chirayujain/LithoLamp/Electronics/DriverBoard/DriverV2_BOM.xlsx

Item # | REFDES | Qty | Manufacturer | MPN/Link | Value/Description | Package
1 | R1 | 1 | YAGEO | RC0603FR-076K04L | 6k | R_0603
2 | R2 | 1 | YAGEO | RC0603FR-0714KL | 14k | R_0603
3 | R3, R4, R5 | 3 | YAGEO | RC0603FR-075K1L | 5.1k | R_0603
4 | R6, R7 | 2 | YAGEO | RC0603JR-0727RL | 27 | R_0603
5 | R8, R12, R14, R15, R16, R17, R18, R19, R20, R21, R24 | 11 | YAGEO | RC0603FR-0710KL | 10k | R_0603
6 | R9 | 1 | Stackpole Electronics | RMCF0603FT10R0 | 10 | R_0603
7 | R10 | 1 | YAGEO | RC0603FR-0749K9L | 49.9k | R_0603
8 | R11, R13 | 2 | YAGEO | RC0603FR-071KL | 1k | R_0603
9 | R26 | 1 |  |  | 0 | R_0603
10 | C1, C2, C3, C4, C5, C7, C8, C9, C11 | 9 | Murata | GRM155R71C104KA88J | 100n | C_0402
11 | C6, C16, C17 | 3 | YAGEO | CC0603KRX7R7BB105 | 1uF | C_0603
12 | C10, C12 | 2 | Taiyo Yuden | LMK105BJ105KV-F | 1u | C_0402
13 | C13, C14, C15 | 3 | Murata | GRT188R61E475KE13D | 4.7uF | C_0603
14 | C18, C19 | 2 | Murata | GRM188R61E106MA73D | 10uF | C_0603
15 | C20 | 1 | Murata | GCM188R71H104KA57J | 100n | C_0603
16 | C21, C22 | 2 | Walsin Technology | 0603N150F500CT | 15pF | C_0603
17 | D1, D2 | 2 | Onsemi | NSR0320MW2T1G | NSR0320MW2T1G | SOD-323
18 | Q1 | 1 | Alpha & Omega Semiconductor | AONR21307 | AONR21307 | 8-DFN-EP (3x3)
19 | Q2, Q3, Q4, Q5 | 4 | Onsemi | BSS138 | BSS138 | SOT23-3
20 | Q7 | 1 | Alpha & Omega Semiconductor | AO3422 | AO3422 | SOT23-3
21 | X1 | 1 | Abracon | ABM8-272-T3 | 12MHz Crystal | 4-SMD
22 | U1 | 1 | Raspberry Pi | SC0914(13) | RP2040 | QFN40P700X700X90-57N
23 | U2 | 1 |  |  | HUSB238 | DFN10_3X3MM
24 | U3 | 1 | Texas Instruments | TLV76750DRVR | TLV76701DRVR | 6-WSON (2x2)
25 | U4 | 1 | Diodes Inc. | AP2112K-3.3TRG1 | AP2112K-3.3TRG1 | SOT-25
26 | U5 | 1 | Winbond Electronics | W25Q128JVSIQ TR | W25Q128JVSIQ | SOIC127P790X216-8N
27 | U6 | 1 | STMicroelectronics | ULN2003D1013TR | ULN2003D | SO-16_STM-M
28 | SW1, SW2 | 2 | C&K | KMR211NG LFS | SPST_TACT-KMR2 | KMR2
29 | J1, J2 | 2 | GCT | USB4105-GF-A | USB4105-GF-A | GCT_USB4105-GF-A
30 | J3 | 1 | JST | B5B-XH-A | B5B-XH | JST_B5B-XH-A(LF)(SN)
31 | J4 | 1 |  |  | PINHD-1X02_1X02M | 1X02
32 | J5 | 1 |  |  | PINHD-1X05_1X05M | 1X05
33 | J6 | 1 |  |  | Solder Jumper | SOLDERJUMPER_ARROW_NOPASTE
