chirayujain/LithoLamp/CAD/STLs/baseTop.stl

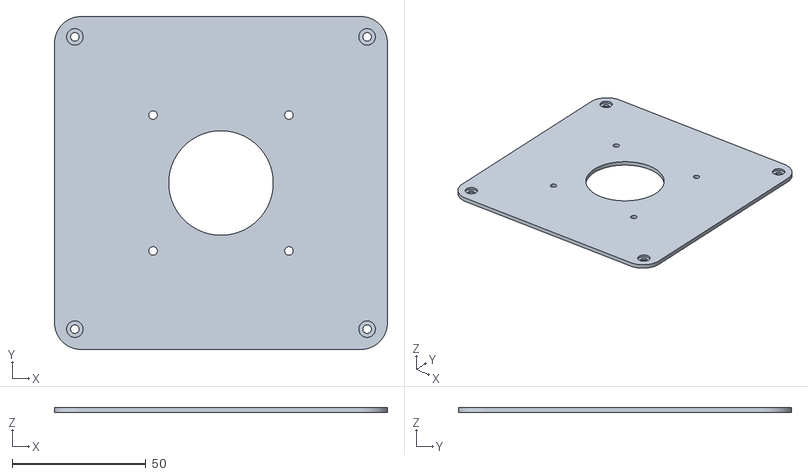
[picture p1: CAD file, 2025-01-18]
CAD/STLs/baseTop.stl
124.5 x 124.5 x 2.00
