chirayujain/LithoLamp/CAD/STLs/tower.stl

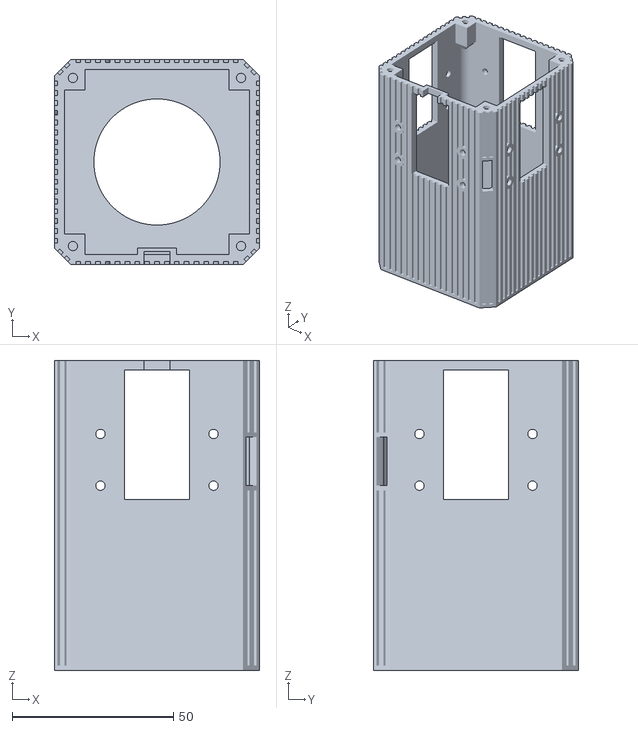
[picture p2: CAD file, 2025-01-18]
CAD/STLs/tower.stl
63.5 x 63.5 x 96.0
