chirayujain/LithoLamp/CAD/STLs/Face Plate.stl

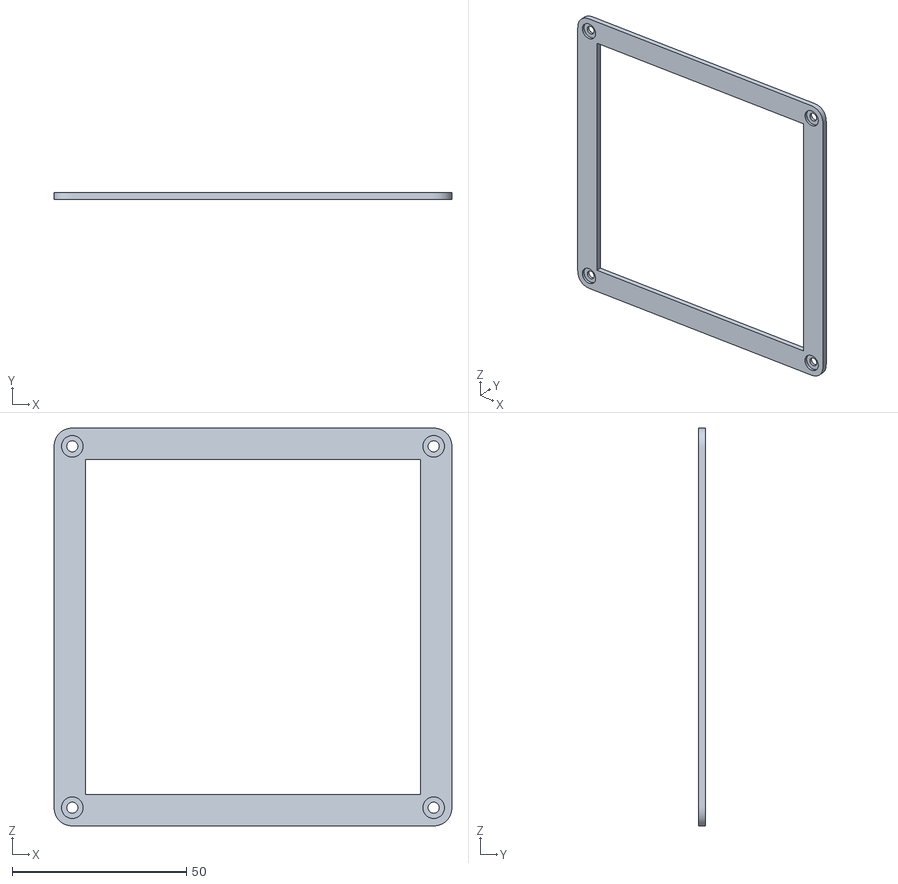
[picture p3: CAD file, 2025-01-18]
CAD/STLs/Face Plate.stl
114.3 x 2.00 x 114.3
