chirayujain/LithoLamp/CAD/STLs/Motor Pin.stl

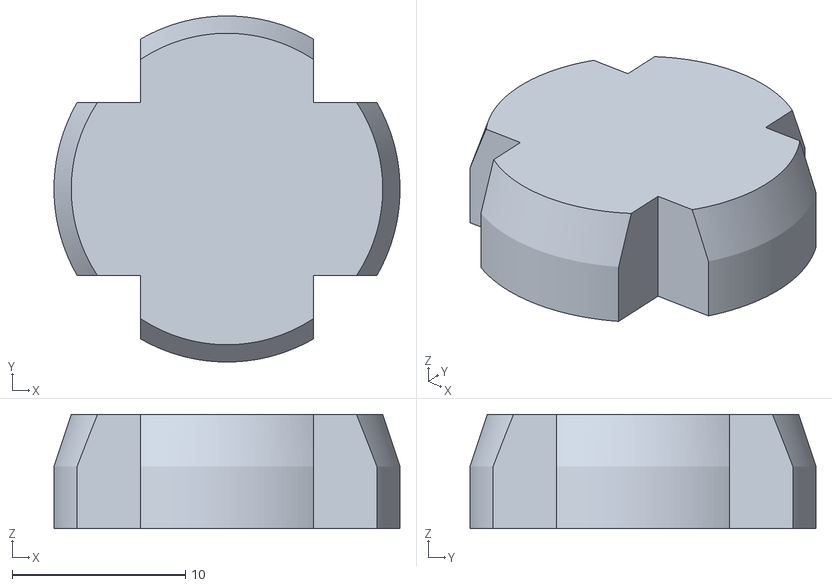
[picture p4: CAD file, 2025-01-18]
CAD/STLs/Motor Pin.stl
20.0 x 20.0 x 6.60
