chirayujain/LithoLamp/CAD/STLs/baseBottom.stl

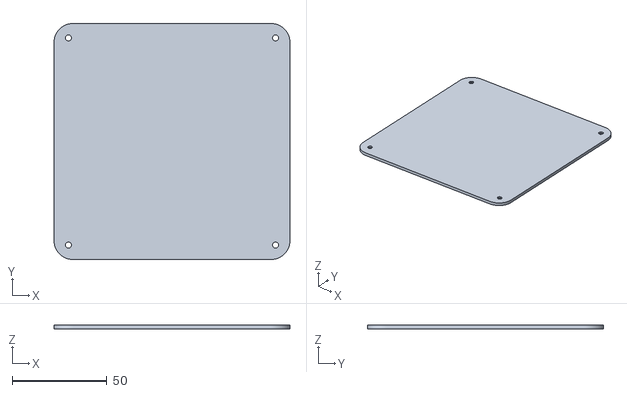
[picture p5: CAD file, 2025-01-18]
CAD/STLs/baseBottom.stl
124.5 x 124.5 x 2.00
