chirayujain/LithoLamp/CAD/STLs/Motor Arm.stl

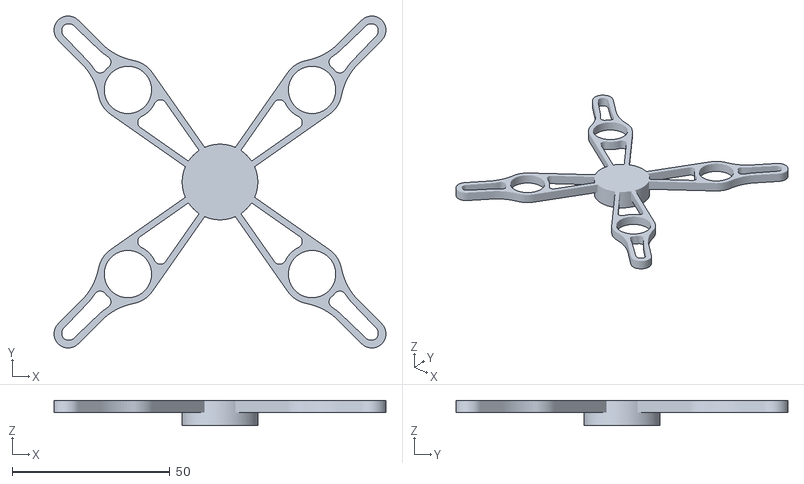
[picture p6: CAD file, 2025-01-18]
CAD/STLs/Motor Arm.stl
105.3 x 105.3 x 8.00
