chirayujain/LithoLamp/CAD/STLs/Frame Top.stl

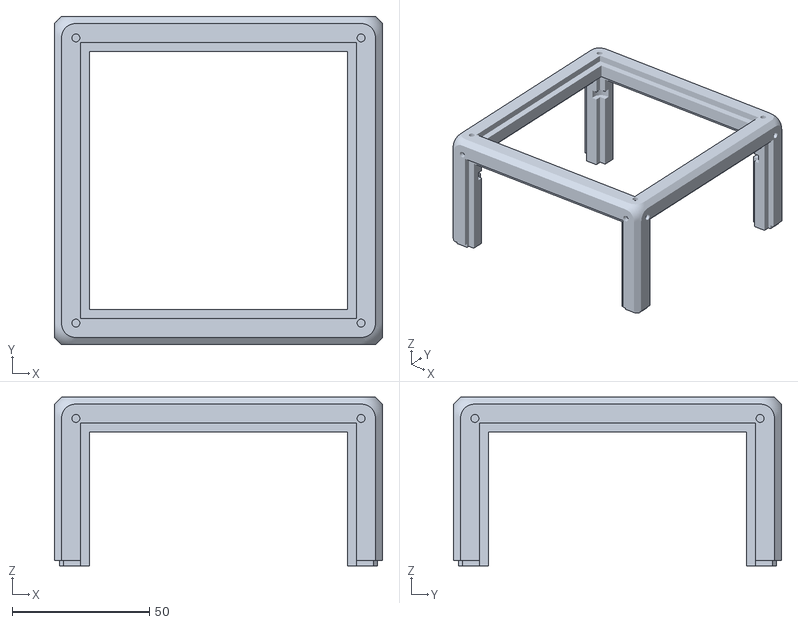
[picture p7: CAD file, 2025-01-18]
CAD/STLs/Frame Top.stl
119.4 x 119.4 x 61.5
