chirayujain/LithoLamp/CAD/STLs/knob v4.stl

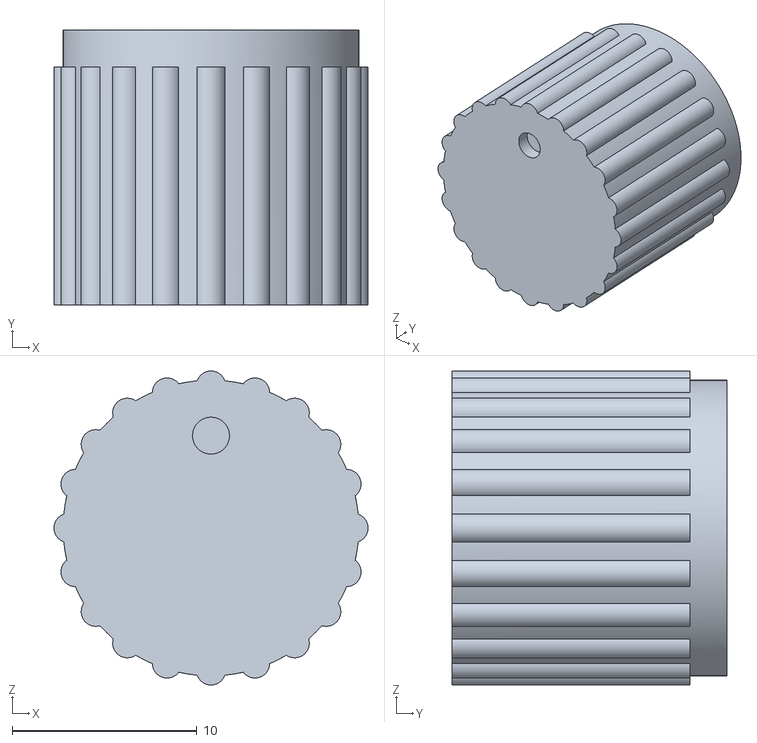
[picture p8: CAD file, 2025-01-18]
CAD/STLs/knob v4.stl
17.0 x 14.9 x 17.0
