chirayujain/LithoLamp/CAD/STLs/Base Housing.stl

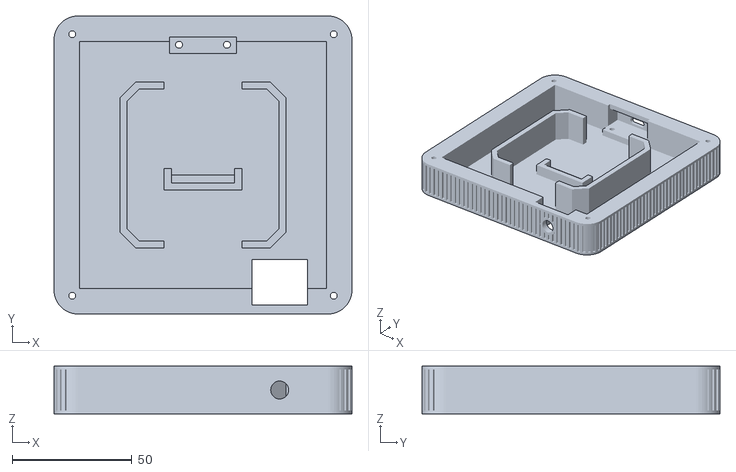
[picture p9: CAD file, 2025-01-18]
CAD/STLs/Base Housing.stl
124.5 x 124.5 x 20.0
