chirayujain/LithoLamp/CAD/STLs/lid.stl

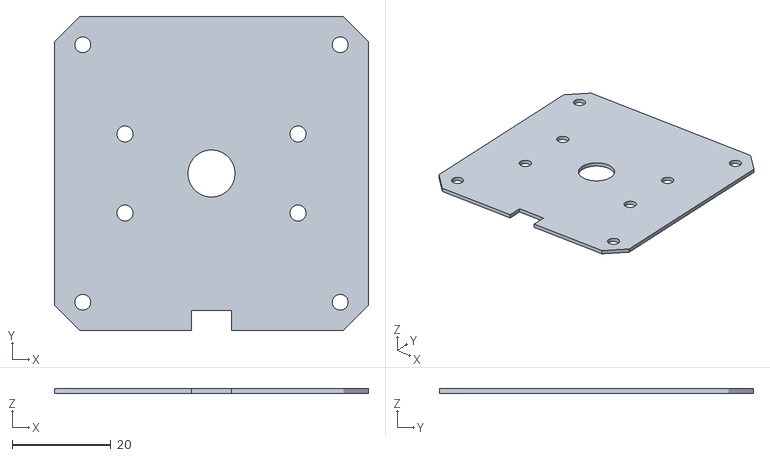
[picture p10: CAD file, 2025-01-18]
CAD/STLs/lid.stl
63.5 x 63.5 x 1.00
