chirayujain/LithoLamp/CAD/STLs/Frame Bottom.stl

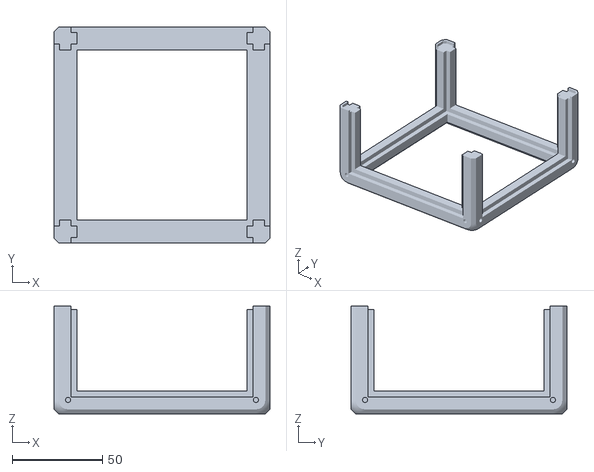
[picture p11: CAD file, 2025-01-18]
CAD/STLs/Frame Bottom.stl
119.4 x 119.4 x 59.7
