chirayujain/LithoLamp/Electronics/DriverBoard/DriverV2.kicad_pcb

## KiCad design Electronics/DriverBoard/DriverV2.kicad_pcb (2025-01-18)

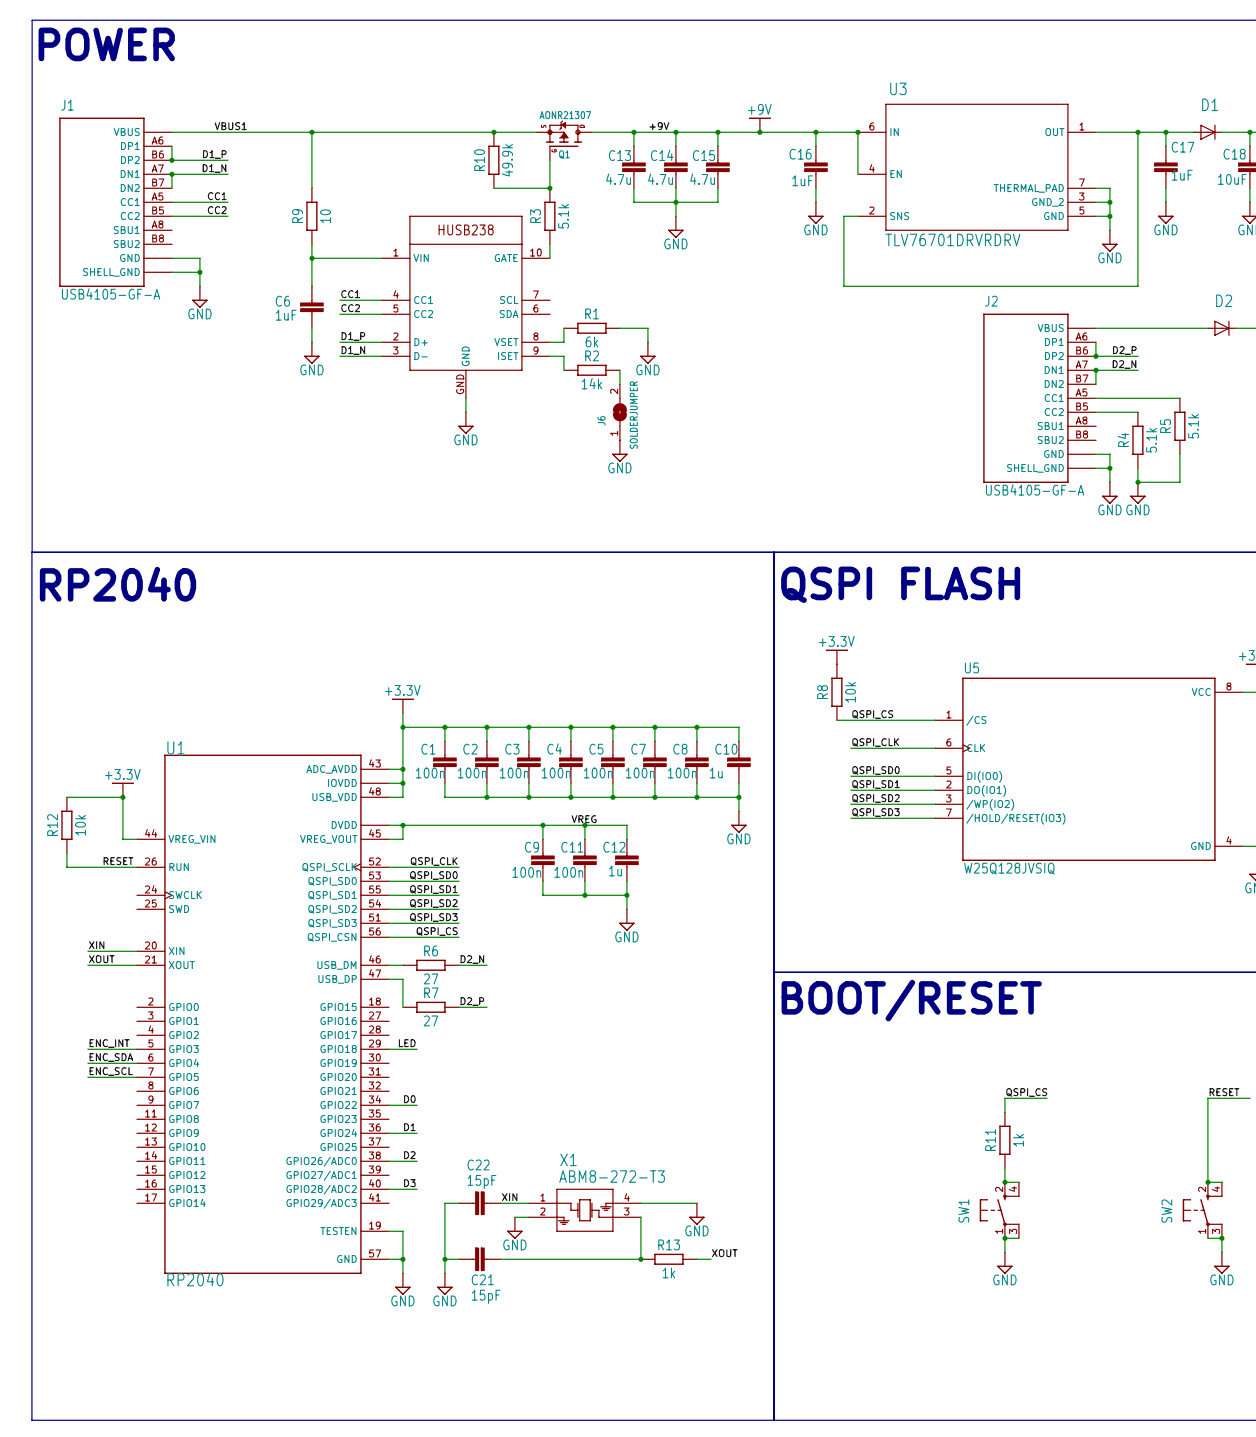
[picture p12: schematic DriverV2.kicad_sch, Driver V2, part in row 1, column 1]

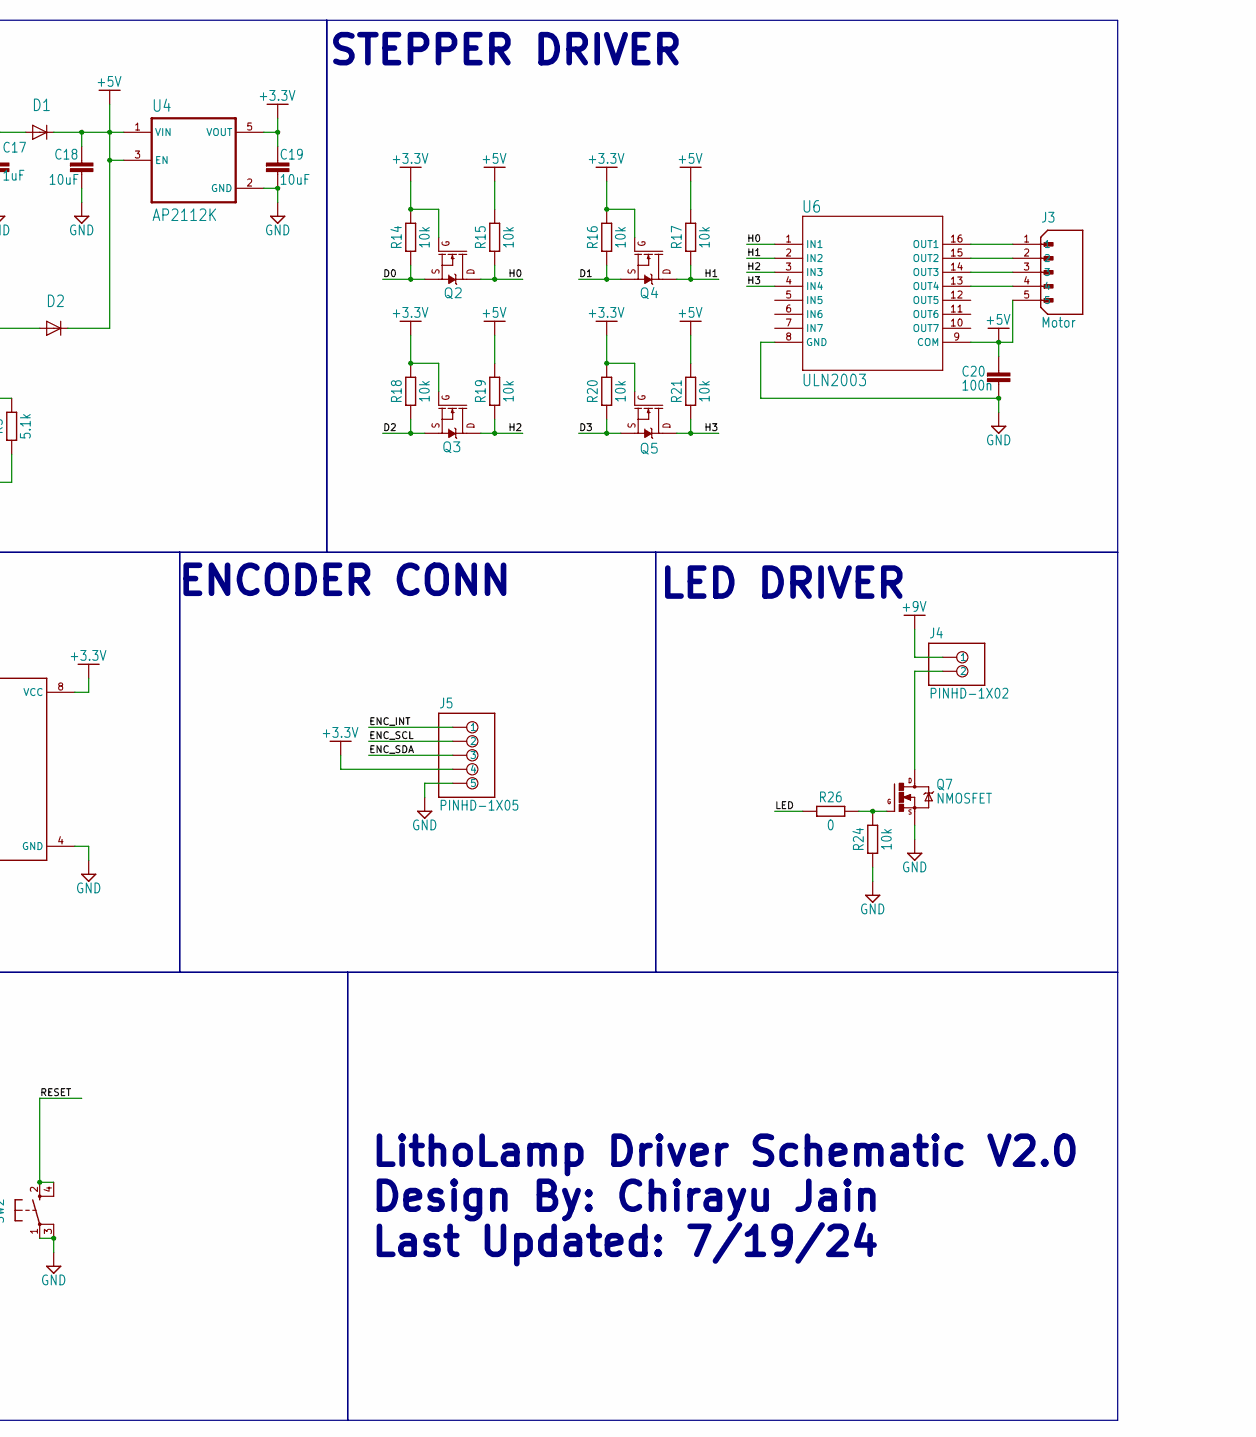
[picture p13: schematic DriverV2.kicad_sch, Driver V2, part in row 1, column 2]

Parts:
C1, C2, C3, C4, C5, C7, C8, C9, C11: 100n; CAPC1005X60
C6, C16, C17: 1uF; CAPC1608X85
C10, C12: 1u; CAPC1005X60
C13, C14, C15: 4.7u; CAPC1608X85
C18, C19: 10uF; CAPC1608X85
C20: 100n; CAPC1608X85
C21, C22: 15pF; CAPC1608X85
D1, D2: NSR0320MW2T1GSOD-323_1P8X1P35_ONS-M; SOD-323_1P8X1P35_ONS-M
J1, J2: USB4105-GF-A; GCT_USB4105-GF-A
J3: Motor; JST_B5B-XH-A(LF)(SN)
J4: PINHD-1X02; 1X02
J5: PINHD-1X05; 1X05
J6: SOLDERJUMPER; SOLDERJUMPER_ARROW_NOPASTE
Q1: AONR21307; POWERDI3333
Q2, Q3, Q4, Q5: 220mA/50V/3.5Ω; SOT23-3
Q7: NMOSFET; SOT23
R1: 6k; RESC1608X60
R2: 14k; RESC1608X60
R3, R4, R5: 5.1k; RESC1608X60
R6, R7: 27; RESC1608X60
R8, R12, R14, R15, R16, R17, R18, R19, R20, R21, R24: 10k; RESC1608X60
R9: 10; RESC1608X60
R10: 49.9k; RESC1608X60
R11, R13: 1k; RESC1608X60
R26: 0; RESC1608X60
SW1, SW2: RESET; KMR2
U1: RP2040; QFN40P700X700X90-57N
U2: HUSB238; DFN10_3X3MM
U3: TLV76701DRVRDRV; DRV0006A-IPC_A
U4: AP2112K; SOT95P285X140-5N
U5: W25Q128JVSIQ; SOIC127P790X216-8N
U6: ULN2003; SO-16_STM-M
X1: ABM8-272-T3; ABM8-272-T3_ABR

Connections:
+3.3V: C1.1, C2.1, C3.1, C4.1, C5.1, C7.1, C8.1, C10.1, C19.1, J5.4, Q2.1 (G), Q3.1 (G), Q4.1 (G), Q5.1 (G), R8.2, R12.2, R14.2, R16.2, R18.2, R20.2, U1.1 (IOVDD), U1.10 (IOVDD), U1.22 (IOVDD), U1.33 (IOVDD), U1.42 (IOVDD), U1.43 (ADC_AVDD), U1.44 (VREG_VIN), U1.48 (USB_VDD), U1.49 (IOVDD), U4.5 (VOUT), U5.8 (VCC)
+5V: C18.1, C20.1, D1.1 (CATHODE), D2.1 (CATHODE), J3.5, R15.2, R17.2, R19.2, R21.2, U4.1 (VIN), U4.3 (EN), U6.9 (COM)
+9V: C13.1, C14.1, C15.1, C16.1, J4.1, Q1.5678 (D), U3.4 (EN), U3.6 (IN)
CC1: J1.A5 (CC1), U2.4 (CC1)
CC2: J1.B5 (CC2), U2.5 (CC2)
D0: Q2.2 (S), R14.1, U1.34 (GPIO22)
D1: Q4.2 (S), R16.1, U1.36 (GPIO24)
D1_N: J1.A7 (DN1), J1.B7 (DN2), U2.3 (D-)
D1_P: J1.A6 (DP1), J1.B6 (DP2), U2.2 (D+)
D2: Q3.2 (S), R18.1, U1.38 (GPIO26/ADC0)
D2_N: J2.A7 (DN1), J2.B7 (DN2), R6.2
D2_P: J2.A6 (DP1), J2.B6 (DP2), R7.2
D3: Q5.2 (S), R20.1, U1.40 (GPIO28/ADC2)
D+: R7.1, U1.47 (USB_DP)
D-: R6.1, U1.46 (USB_DM)
ENC_INT: J5.1, U1.5 (GPIO3)
ENC_SCL: J5.2, U1.7 (GPIO5)
ENC_SDA: J5.3, U1.6 (GPIO4)
GATE: R3.1, U2.10 (GATE)
H0: Q2.3 (D), R15.1, U6.1 (IN1)
H1: Q4.3 (D), R17.1, U6.2 (IN2)
H2: Q3.3 (D), R19.1, U6.3 (IN3)
H3: Q5.3 (D), R21.1, U6.4 (IN4)
ISET: R2.1, U2.9 (ISET)
LED: R26.1, U1.29 (GPIO18)
unnamed: C6.1, R9.1, U2.1 (VIN)
unnamed: Q1.4 (G), R3.2, R10.1
unnamed: J6.2, R2.2
unnamed: J2.A5 (CC1), R5.2
unnamed: J2.B5 (CC2), R4.2
unnamed: D2.2 (ANODE), J2.A4_B9 (VBUS), J2.B4_A9 (VBUS)
unnamed: C17.1, D1.2 (ANODE), U3.1 (OUT), U3.2 (SNS)
unnamed: J3.1, U6.16 (OUT1)
unnamed: R11.1, SW1.2 (S), SW1.4 (S1)
unnamed: C21.1, R13.1, X1.3
unnamed: J3.2, U6.15 (OUT2)
unnamed: J3.3, U6.14 (OUT3)
unnamed: J3.4, U6.13 (OUT4)
unnamed: J4.2, Q7.3 (D)
unnamed: Q7.1 (G), R24.2, R26.2
QSPI_CLK: U1.52 (QSPI_SCLK), U5.6 (CLK)
QSPI_CS: R8.1, R11.2, U1.56 (QSPI_CSN), U5.1 (/CS)
QSPI_SD0: U1.53 (QSPI_SD0), U5.5 (DI(IO0))
QSPI_SD1: U1.55 (QSPI_SD1), U5.2 (DO(IO1))
QSPI_SD2: U1.54 (QSPI_SD2), U5.3 (/WP(IO2))
QSPI_SD3: U1.51 (QSPI_SD3), U5.7 (/HOLD/RESET(IO3))
RESET: R12.1, SW2.2 (S), SW2.4 (S1), U1.26 (RUN)
VBUS1: J1.A4_B9 (VBUS), J1.B4_A9 (VBUS), Q1.1 (S), Q1.2 (S), Q1.3 (S), R9.2, R10.2
VREG: C9.1, C11.1, C12.1, U1.23 (DVDD), U1.45 (VREG_VOUT), U1.50 (DVDD)
VSET: R1.1, U2.8 (VSET)
XIN: C22.1, U1.20 (XIN), X1.1
XOUT: R13.2, U1.21 (XOUT)

Notes on the sheet:
LithoLamp Driver Schematic V2.0 Design By: Chirayu Jain Last Updated: 7/19/24
STEPPER DRIVER
RP2040
QSPI FLASH
ENCODER CONN
BOOT/RESET
LED DRIVER
POWER

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
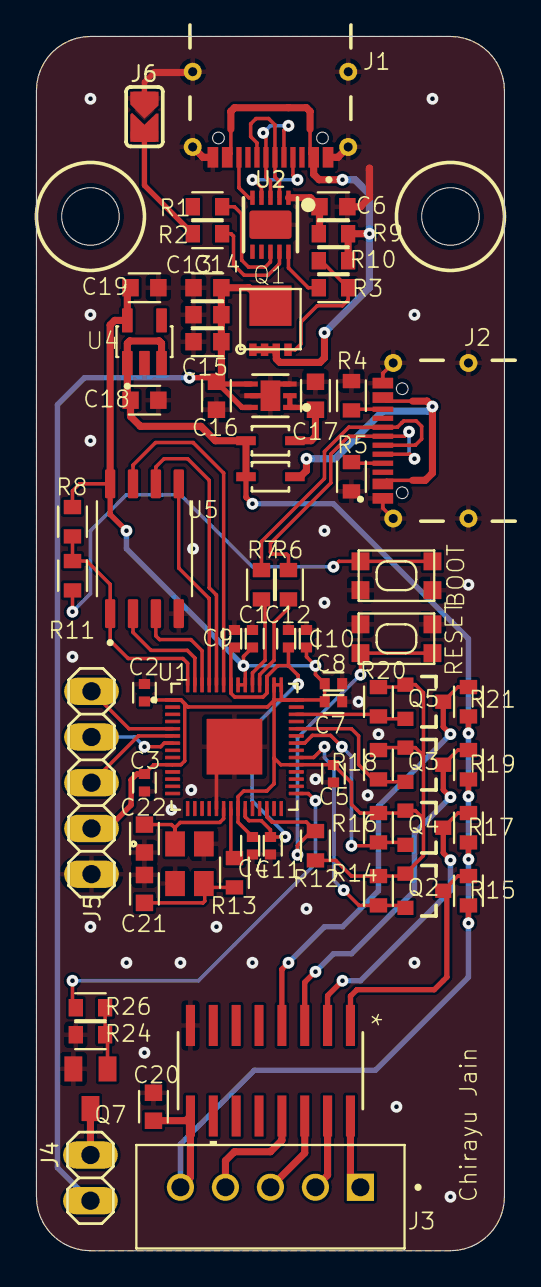
[picture p14: board DriverV2.kicad_pcb from above]

Board: 2 copper layers, 26.0 x 67.5 mm, 70 parts (0 on the bottom side), 53 nets.

Other parts of the board:
@HOLE0, @HOLE1: (no value)
