chirayujain/LithoLamp/Electronics/LEDBoard/LEDBoard.brd

## EAGLE design Electronics/LEDBoard/LEDBoard.brd (2025-01-18)

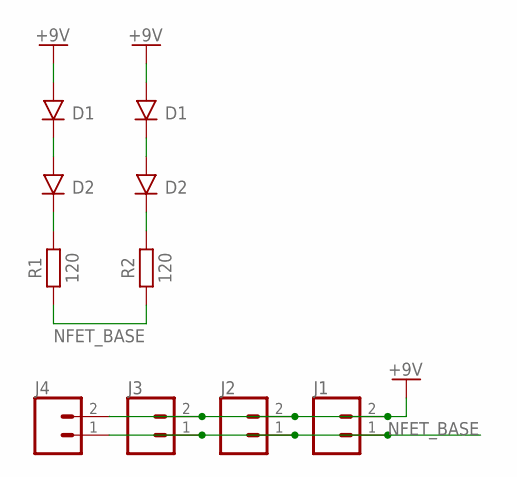
[picture p15: schematic LEDBoard.sch]

Parts:
D1, D2, D3, D4: JB3030
J1, J2, J3, J4: CONN_021X02_NO_SILK; 1X02_NO_SILK
R1, R2: 120; RESC2012X65

Connections:
+9V: D1.A, D3.A, J1.2, J2.2, J3.2, J4.2
unnamed: D1.C, D2.A
unnamed: D2.C, R1.2
unnamed: D3.C, D4.A
unnamed: D4.C, R2.2
NFET_BASE: J1.1, J2.1, J3.1, J4.1, R1.1, R2.1

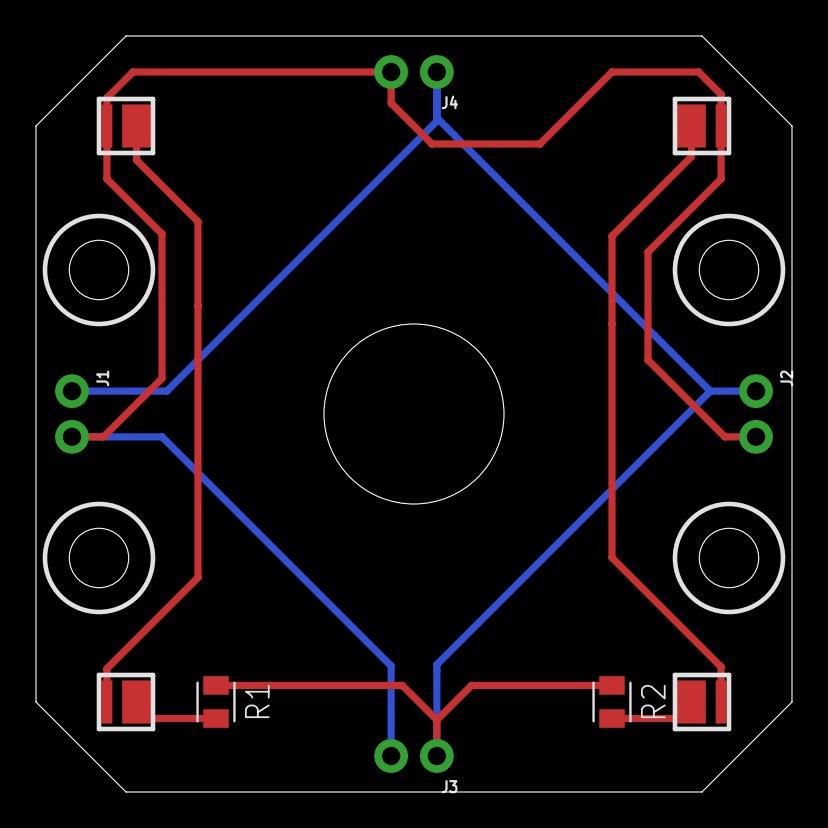
[picture p16: board LEDBoard.brd from above]

Board: 2 copper layers, 42.0 x 42.0 mm, 10 parts (0 on the bottom side), 6 nets.
